MajicDesigns/Relay-Timer/doc/Relay_Timer_Top_View.JPG

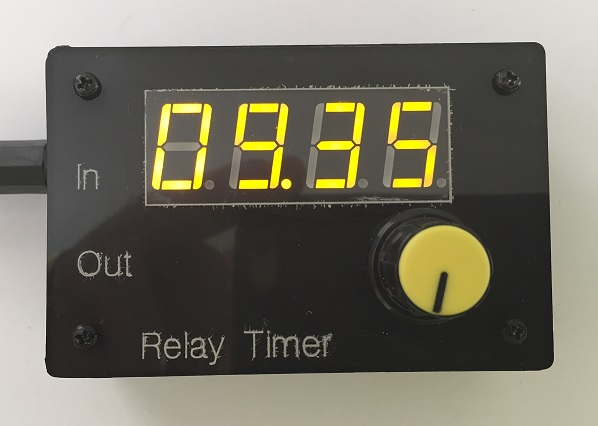
doc/Relay_Timer_Top_View.JPG
