MajicDesigns/Relay-Timer/doc/Relay_Timer_Diagrams.pptx

LED Display

Arduino Mini

Output Relay

Select Switch

Rotary Encoder

PS Module

INIT

Init
complete

IDLE

Rotary Encoder Setting

Clean up
and reset
FSM

Switch PRESS

START

RUN init complete

END

Timer Expired

RUNNING

Switch LONGPRESS

Switch PRESS

PAUSE

Switch PRESS
