MajicDesigns/Relay-Timer/doc/Relay_Timer_Block_Diagram.png

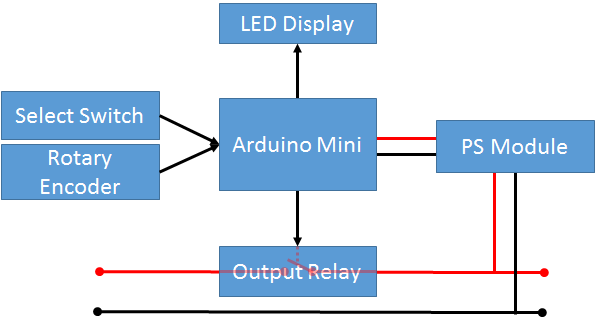
doc/Relay_Timer_Block_Diagram.png
