MajicDesigns/Relay-Timer/doc/Relay_Timer_Open_View - labelled.jpg

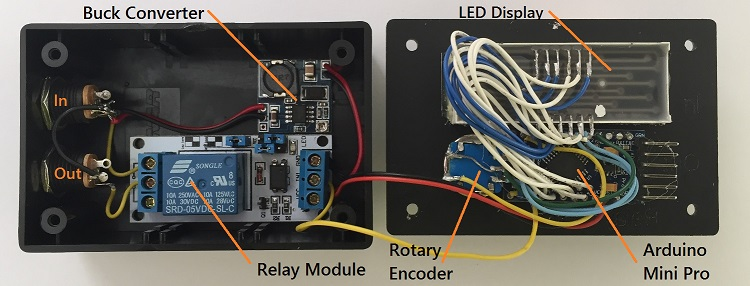
doc/Relay_Timer_Open_View - labelled.jpg
