MajicDesigns/Relay-Timer/doc/Relay_Timer_Open_View.jpg

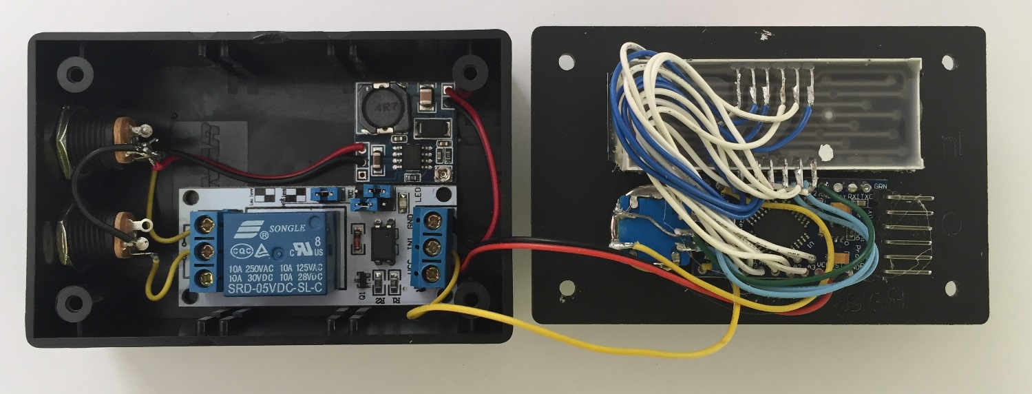
doc/Relay_Timer_Open_View.jpg
