MajicDesigns/Relay-Timer/doc/Relay_Timer_Ortho_View.JPG

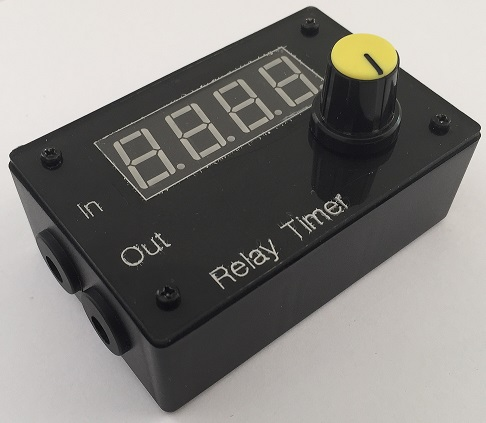
doc/Relay_Timer_Ortho_View.JPG
