MajicDesigns/Relay-Timer/doc/relay_timer_Schematic.JPG

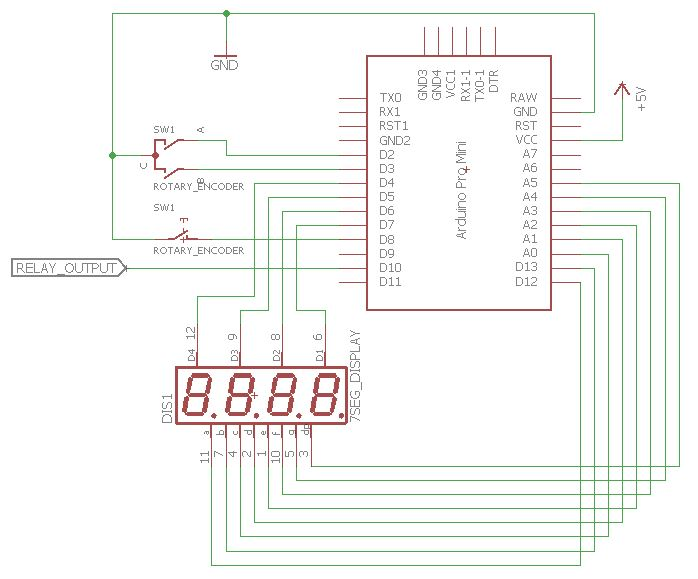
doc/relay_timer_Schematic.JPG
