MajicDesigns/Relay-Timer/doc/Relay_Timer_State_Diagram.png

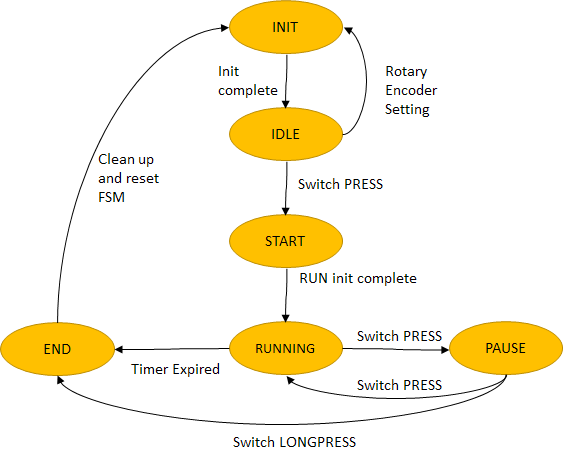
doc/Relay_Timer_State_Diagram.png
